jeffmakes/tr19-badge-hw-public/assembly/tr19-badge-B.Assembly.pdf

C7 C8 | C9

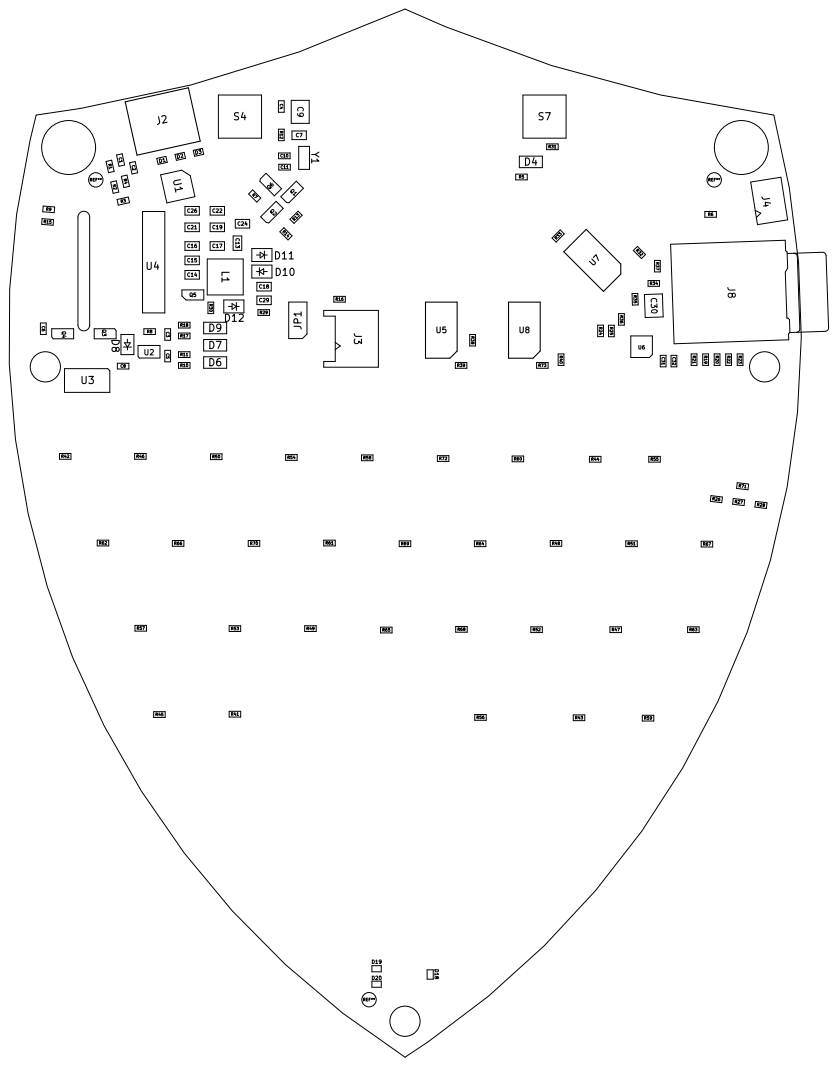
[picture p1: page 1]
