jeffmakes/tr19-badge-hw-public/assembly/tr19-badge-F.Assembly.pdf

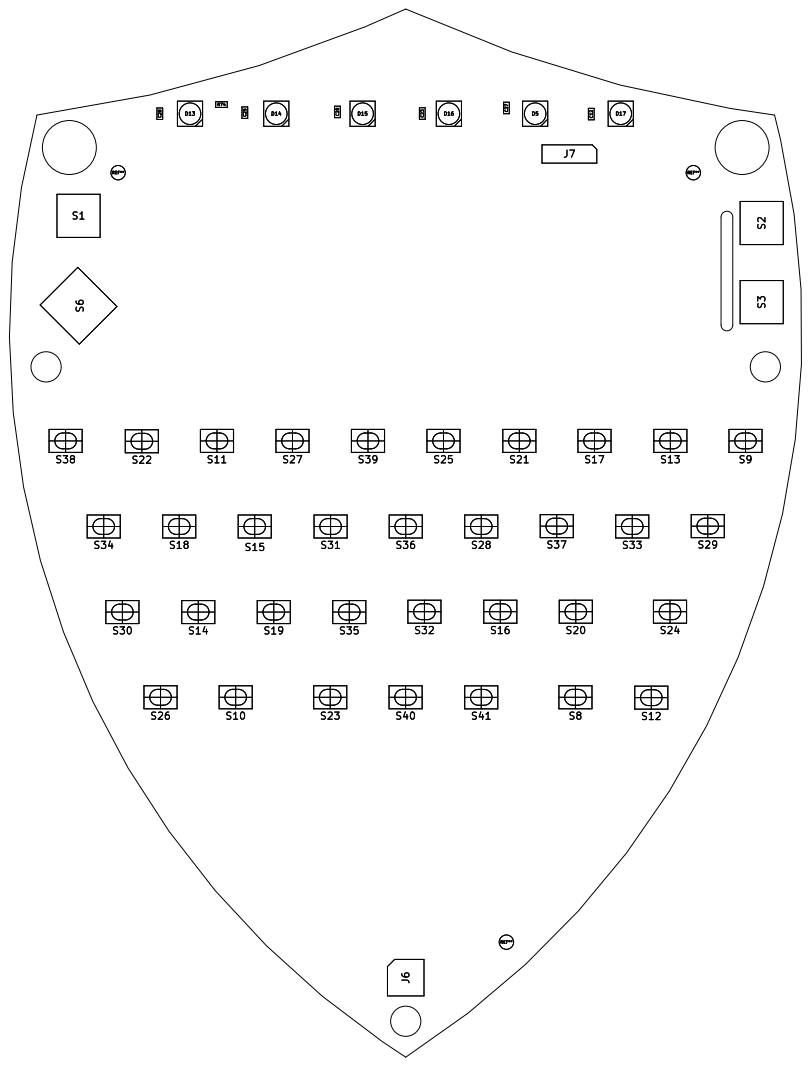
[picture p2: page 1]
