jeffmakes/tr19-badge-hw-public/gerber/panelisation-6-up.pdf

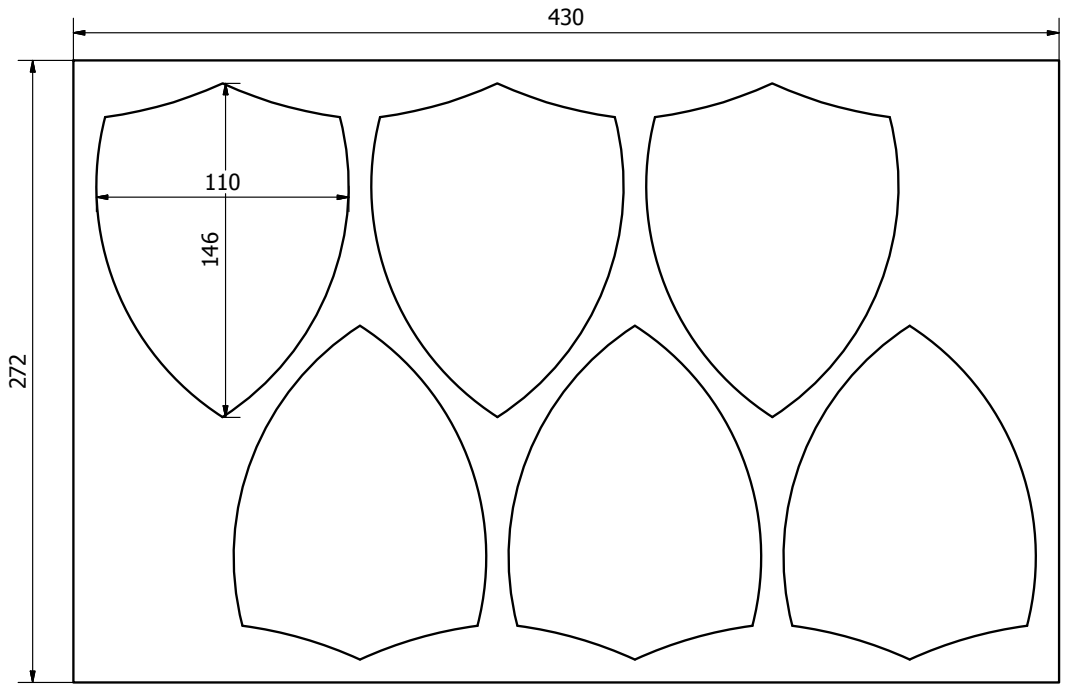
[picture p3: page 1]
Panelisation 2; Alan Ambrose; Designed by; Checked by; Approved by; Date
