jeffmakes/tr19-badge-hw-public/tr19-badge.kicad/tr19-badge.kicad_pcb

## KiCad design tr19-badge.kicad/tr19-badge.kicad_pcb (2019-07-17)

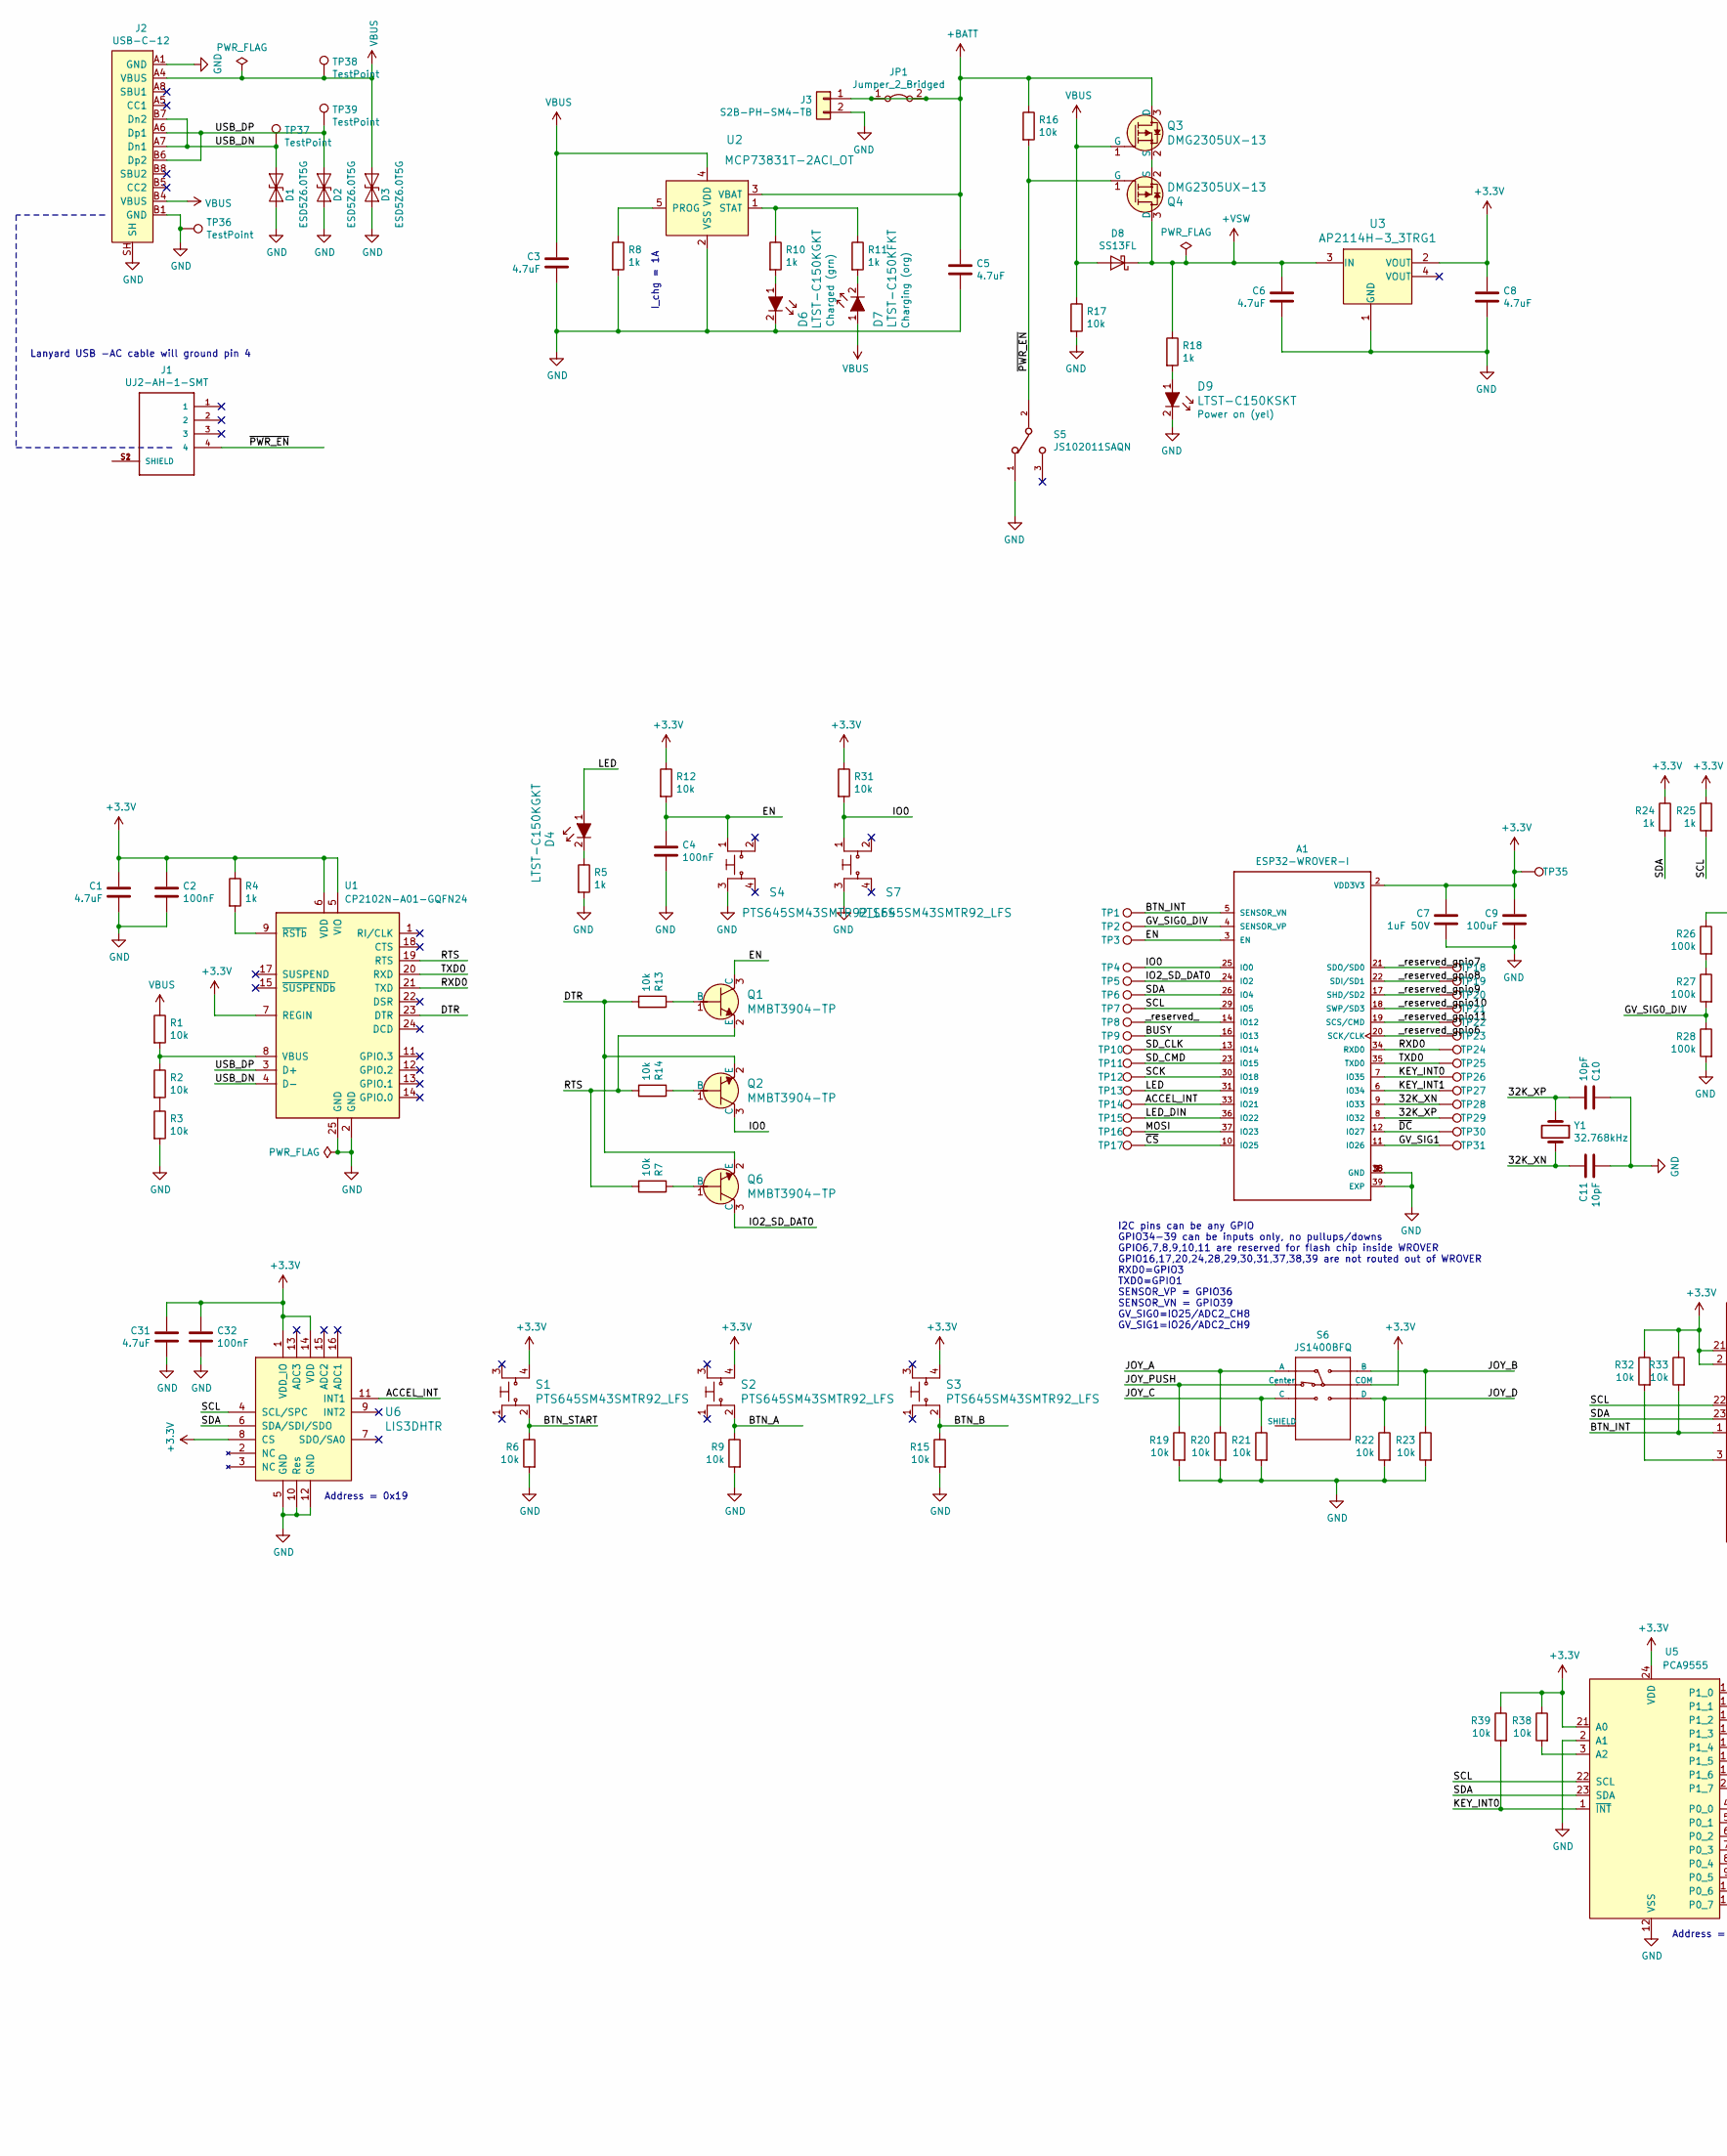
[picture p4: schematic tr19-badge.sch, part in row 1, column 1]

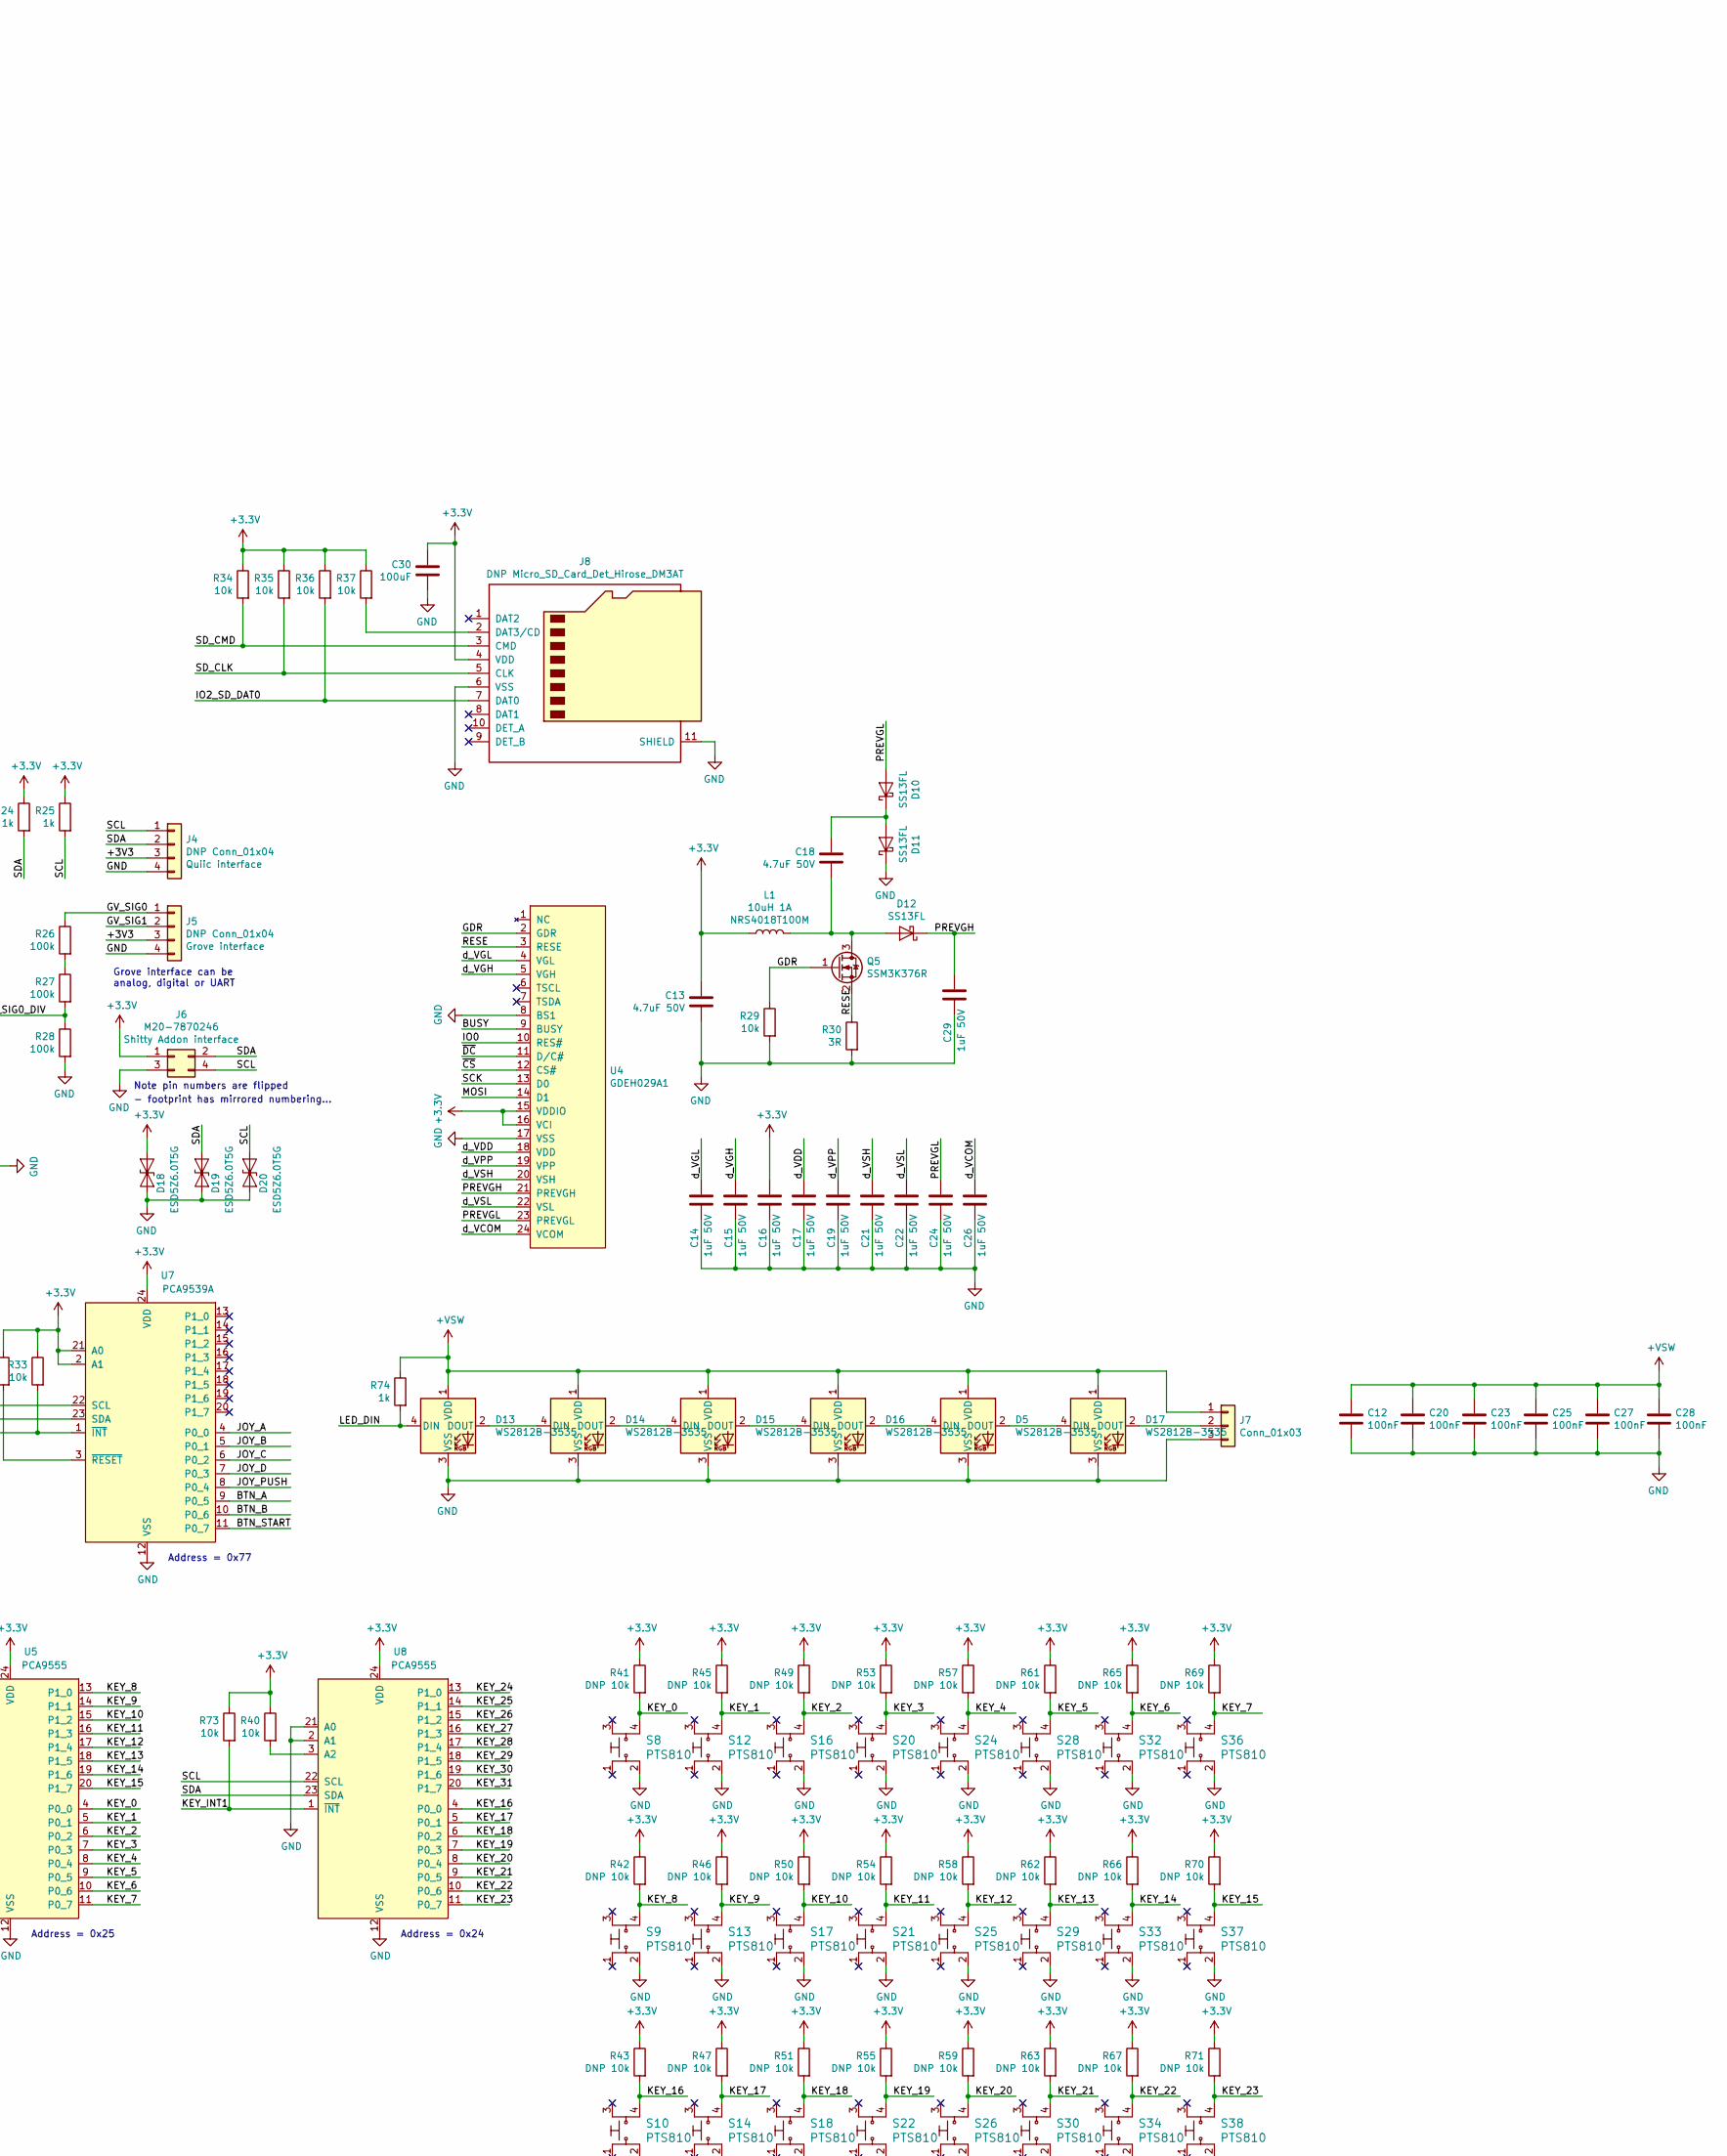
[picture p5: schematic tr19-badge.sch, part in row 1, column 2]

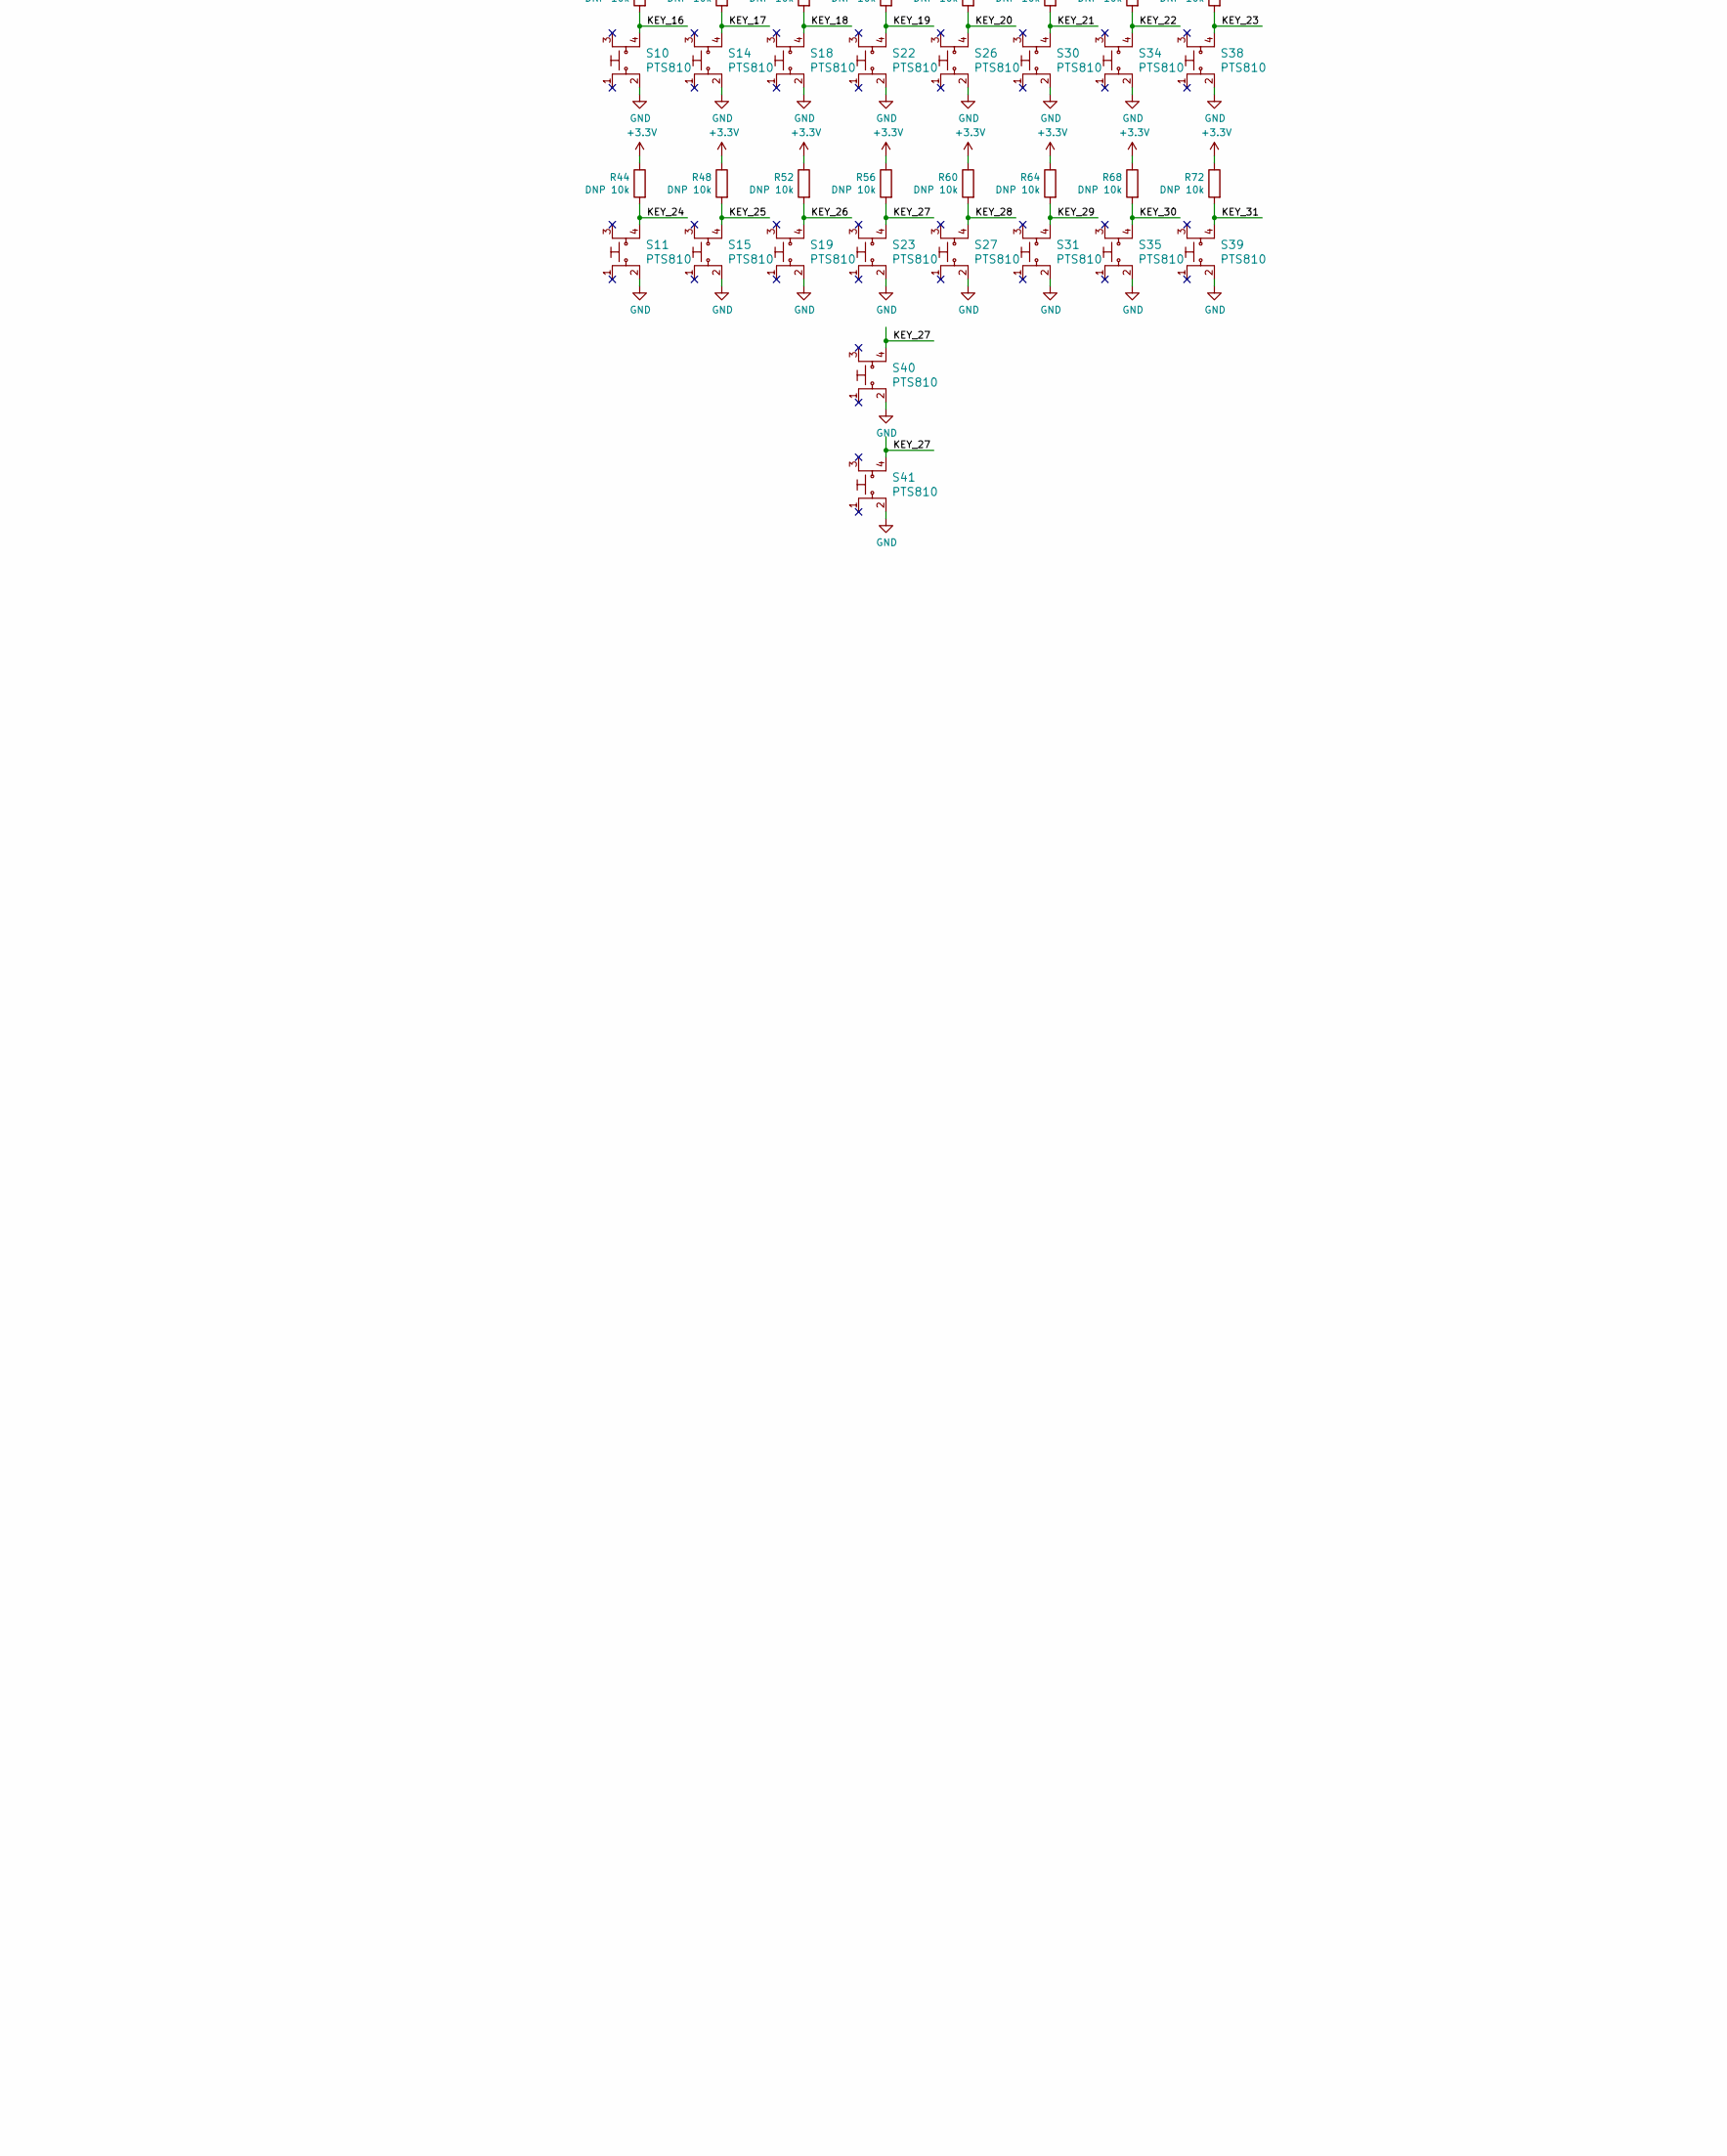
[picture p6: schematic tr19-badge.sch, part in row 2, column 2]

Parts:
A1: ESP32-WROVER-I
C1, C3, C5, C6, C8, C31: 4.7uF; C_0603_1608Metric
C2, C4, C12, C20, C23, C25, C27, C28, C32: 100nF; C_0603_1608Metric
C7, C14, C15, C16, C17, C19, C21, C22, C24, C26, C29: 1uF 50V; C_0805_2012Metric
C9, C30: 100uF; C_1210_3225Metric
C10, C11: 10pF; C_0603_1608Metric
C13, C18: 4.7uF 50V; C_0805_2012Metric
D1, D2, D3, D18, D19, D20: ESD5Z6.0T5G; SOD-523-numbered-pads; MPN ESD5Z5.0VC
D4, D6: LTST-C150KGKT; 1206; MPN LTST-C150KGKT; Digi-Key_PN 160-1404-1-ND
D5, D13, D14, D15, D16, D17: WS2812B-3535; LED_SK6812MINI_PLCC4_3.5x3.5mm_P1.75mm_no_silk
D7: LTST-C150KFKT; 1206; MPN LTST-C150KSKT; Digi-Key_PN 160-1406-1-ND
D8, D10, D11, D12: SS13FL; D_SOD-123F
D9: LTST-C150KSKT; 1206; MPN LTST-C150KSKT; Digi-Key_PN 160-1406-1-ND
J1: UJ2-AH-1-SMT; jing-lcsc-C46400
J2: USB-C-12; jing-usb-c-lcsc-C167321
J3: S2B-PH-SM4-TB; JST_PH_S2B-PH-SM4-TB_1x02-1MP_P2.00mm_Horizontal
J4: DNP Conn_01x04; JST_SH_SM04B-SRSS-TB_1x04-1MP_P1.00mm_Horizontal
J5: DNP Conn_01x04; 1125R-SMT-4P
J6: M20-7870246; PinSocket_2x02_P2.54mm_Vertical_mirror_numbering
J7: Conn_01x03; PinHeader_1x03_P2.54mm_Vertical
J8: DNP Micro_SD_Card_Det_Hirose_DM3AT; microSD_HC_Hirose_DM3AT-SF-PEJM5
JP1: Jumper_2_Bridged; PinHeader_1x02_P2.54mm_Vertical
L1: 10uH 1A; L_Taiyo-Yuden_MD-5050; MPN NRS4018T100M
Q1, Q2, Q6: MMBT3904-TP; SOT-23-3; MPN MMBT3904-TP; Digi-Key_PN MMBT3904TPMSCT-ND
Q3, Q4: DMG2305UX-13; SOT-23-3; MPN DMG2305UX-13; Digi-Key_PN DMG2305UX-13DICT-ND
Q5: SSM3K376R; SOT-23
R1, R2, R3, R6, R7, R9, R12, R13, R14, R15, R16, R17, R19, R20, R21, R22, R23, R29, R31, R32, R33, R34, R35, R36, R37, R38, R39, R40, R73: 10k; R_0603_1608Metric
R4, R5, R8, R10, R11, R18, R24, R25, R74: 1k; R_0603_1608Metric
R26, R27, R28: 100k; R_0603_1608Metric
R30: 3R; R_0603_1608Metric
R41, R42, R43, R44, R45, R46, R47, R48, R49, R50, R51, R52, R53, R54, R55, R56, R57, R58, R59, R60, R61, R62, R63, R64, R65, R66, R67, R68, R69, R70, R71, R72: DNP 10k; R_0603_1608Metric
S1, S2, S3, S4, S7: PTS645SM43SMTR92_LFS; Switch_Tactile_SMD_6x6mm_PTS645; MPN PTS645SM43SMTR92 LFS; Digi-Key_PN CKN9112CT-ND
S5: JS102011SAQN; SW_JS102011SAQN
S6: JS1400BFQ; SW_JS1400BFQ-arrows
S8, S9, S10, S11, S12, S13, S14, S15, S16, S17, S18, S19, S20, S21, S22, S23, S24, S25, S26, S27, S28, S29, S30, S31, S32, S33, S34, S35, S36, S37, S38, S39, S40, S41: PTS810; PTS-810; MPN PTS645SM43SMTR92 LFS; Digi-Key_PN CKN9112CT-ND
TP1, TP2, TP3, TP4, TP5, TP6, TP7, TP8, TP9, TP10, TP11, TP12, TP13, TP14, TP15, TP16, TP17, TP18, TP19, TP20, TP21, TP22, TP23, TP24, TP25, TP26, TP27, TP28, TP29, TP30, TP31, TP35: test-pad-1.4-TH
TP36, TP37, TP38, TP39: TestPoint; test-pad-1.4-TH
U1: CP2102N-A01-GQFN24; QFN-24-1EP_4x4mm_P0.5mm_EP2.6x2.6mm
U2: MCP73831T-2ACI_OT; SOT-753; MPN MCP73831T-2ACI/OT; Digi-Key_PN MCP73831T-2ACI/OTCT-ND
U3: AP2114H-3_3TRG1; SOT-223; MPN AP2114H-3.3TRG1; Digi-Key_PN AP2114H-3.3TRG1DICT-ND
U4: GDEH029A1
U5, U8: PCA9555; TSSOP-24_4.4x7.8mm_P0.65mm
U6: LIS3DHTR; VFLGA-16_3x3mm; MPN LIS3DHTR; Digi-Key_PN 497-10613-1-ND
U7: PCA9539A; TSSOP-24_4.4x7.8mm_P0.65mm
Y1: 32.768kHz; Crystal_SMD_3215-2Pin_3.2x1.5mm; MPN SSP-T7-F

Connections:
+BATT: C5.1, J3.1, JP1.1 (A), JP1.2 (B), Q3.3 (D), R16.1, U2.3 (VBAT)
+VSW: C6.1, C12.1, C20.1, C23.1, C25.1, C27.1, C28.1, D5.1 (VDD), D8.1 (K), D13.1 (VDD), D14.1 (VDD), D15.1 (VDD), D16.1 (VDD), D17.1 (VDD), J7.1, Q4.3 (D), R18.1, R74.1, U3.3 (IN)
/32K_XN: A1.9 (IO33), C11.1, TP28.1, Y1.2
/32K_XP: A1.8 (IO32), C10.2, TP29.1, Y1.1
/ACCEL_INT: A1.33 (IO21), TP14.1, U6.11 (INT1)
/BTN_A: R9.1, S2.2, U7.9 (P0_5)
/BTN_B: R15.1, S3.2, U7.10 (P0_6)
/BTN_INT: A1.5 (SENSOR_VN), R33.2, TP1.1, U7.1 (~INT~)
/BTN_START: R6.1, S1.2, U7.11 (P0_7)
/BUSY: A1.16 (IO13), TP9.1, U4.9 (BUSY)
/DTR: Q2.2 (E), Q6.2 (E), R13.2, U1.23 (DTR)
/EN: A1.3 (EN), C4.1, Q1.3 (C), R12.2, S4.1, TP3.1
/GDR: Q5.1 (G), R29.1, U4.2 (GDR)
/GV_SIG0: J5.1, R26.1
/GV_SIG0_DIV: A1.4 (SENSOR_VP), R27.2, R28.1, TP2.1
/GV_SIG1: A1.11 (IO26), J5.2, TP31.1
/IO0: A1.25 (IO0), Q2.3 (C), R31.2, S7.1, TP4.1, U4.10 (RES#)
/IO2_SD_DAT0: A1.24 (IO2), J8.7 (DAT0), Q6.3 (C), R36.2, TP5.1
/JOY_A: R20.1, S6.1 (A), U7.4 (P0_0)
/JOY_B: R23.1, S6.4 (B), U7.5 (P0_1)
/JOY_C: R21.1, S6.3 (C), U7.6 (P0_2)
/JOY_D: R22.1, S6.6 (D), U7.7 (P0_3)
/JOY_PUSH: R19.1, S6.2 (Center), U7.8 (P0_4)
/KEY_0: R41.2, S8.4, U5.4 (P0_0)
/KEY_1: R45.2, S12.4, U5.5 (P0_1)
/KEY_2: R49.2, S16.4, U5.6 (P0_2)
/KEY_3: R53.2, S20.4, U5.7 (P0_3)
/KEY_4: R57.2, S24.4, U5.8 (P0_4)
/KEY_5: R61.2, S28.4, U5.9 (P0_5)
/KEY_6: R65.2, S32.4, U5.10 (P0_6)
/KEY_7: R69.2, S36.4, U5.11 (P0_7)
/KEY_8: R42.2, S9.4, U5.13 (P1_0)
/KEY_9: R46.2, S13.4, U5.14 (P1_1)
/KEY_10: R50.2, S17.4, U5.15 (P1_2)
/KEY_11: R54.2, S21.4, U5.16 (P1_3)
/KEY_12: R58.2, S25.4, U5.17 (P1_4)
/KEY_13: R62.2, S29.4, U5.18 (P1_5)
/KEY_14: R66.2, S33.4, U5.19 (P1_6)
/KEY_15: R70.2, S37.4, U5.20 (P1_7)
/KEY_16: R43.2, S10.4, U8.4 (P0_0)
/KEY_17: R47.2, S14.4, U8.5 (P0_1)
/KEY_18: R51.2, S18.4, U8.6 (P0_2)
/KEY_19: R55.2, S22.4, U8.7 (P0_3)
/KEY_20: R59.2, S26.4, U8.8 (P0_4)
/KEY_21: R63.2, S30.4, U8.9 (P0_5)
/KEY_22: R67.2, S34.4, U8.10 (P0_6)
/KEY_23: R71.2, S38.4, U8.11 (P0_7)
/KEY_24: R44.2, S11.4, U8.13 (P1_0)
/KEY_25: R48.2, S15.4, U8.14 (P1_1)
/KEY_26: R52.2, S19.4, U8.15 (P1_2)
/KEY_27: R56.2, S23.4, S40.4, S41.4, U8.16 (P1_3)
/KEY_28: R60.2, S27.4, U8.17 (P1_4)
/KEY_29: R64.2, S31.4, U8.18 (P1_5)
/KEY_30: R68.2, S35.4, U8.19 (P1_6)
/KEY_31: R72.2, S39.4, U8.20 (P1_7)
/KEY_INT0: A1.7 (IO35), R39.2, TP26.1, U5.1 (~INT~)
/KEY_INT1: A1.6 (IO34), R73.2, TP27.1, U8.1 (~INT~)
/LED: A1.31 (IO19), D4.1, TP13.1
/LED_DIN: A1.36 (IO22), D13.4 (DIN), R74.2, TP15.1
/MOSI: A1.37 (IO23), TP16.1, U4.14 (D1)
/PREVGH: C29.2, D12.1 (K), U4.21 (PREVGH)
/PREVGL: C24.2, D10.2 (A), U4.23 (PREVGL)
/RESE: Q5.2 (S), R30.1, U4.3 (RESE)
/RTS: Q1.2 (E), R7.2, R14.2, U1.19 (RTS)
/RXD0: A1.34 (RXD0), TP24.1, U1.21 (TXD)
/SCK: A1.30 (IO18), TP12.1, U4.13 (D0)
/SCL: A1.29 (IO5), D20.1 (A1), J4.1, J6.4, R25.2, TP7.1, U5.22 (SCL), U6.4 (SCL/SPC), U7.22 (SCL), U8.22 (SCL)
/SDA: A1.26 (IO4), D19.1 (A1), J4.2, J6.2, R24.2, TP6.1, U5.23 (SDA), U6.6 (SDA/SDI/SDO), U7.23 (SDA), U8.23 (SDA)
/SD_CLK: A1.13 (IO14), J8.5 (CLK), R35.2, TP10.1
/SD_CMD: A1.23 (IO15), J8.3 (CMD), R34.2, TP11.1
/TXD0: A1.35 (TXD0), TP25.1, U1.20 (RXD)
/USB_DN: D1.1 (A1), J2.A7 (Dn1), J2.B7 (Dn2), TP37.1, U1.4 (D-)
/USB_DP: D2.1 (A1), J2.A6 (Dp1), J2.B6 (Dp2), TP39.1, U1.3 (D+)
/_reserved_: A1.14 (IO12), TP8.1
/_reserved_gpio6: A1.20 (SCK/CLK), TP23.1
/_reserved_gpio7: A1.21 (SDO/SD0), TP18.1
/_reserved_gpio8: A1.22 (SDI/SD1), TP19.1
/_reserved_gpio9: A1.17 (SHD/SD2), TP20.1
/_reserved_gpio10: A1.18 (SWP/SD3), TP21.1
/_reserved_gpio11: A1.19 (SCS/CMD), TP22.1
/d_VCOM: C26.2, U4.24 (VCOM)
/d_VDD: C17.2, U4.18 (VDD)
/d_VGH: C15.2, U4.5 (VGH)
/d_VGL: C14.2, U4.4 (VGL)
/d_VPP: C19.2, U4.19 (VPP)
/d_VSH: C21.2, U4.20 (VSH)
/d_VSL: C22.2, U4.22 (VSL)
/~CS~: A1.10 (IO25), TP17.1, U4.12 (CS#)
/~DC~: A1.12 (IO27), TP30.1, U4.11 (D/C#)
/~PWR_EN~: J1.4, Q4.1 (G), R16.2, S5.2
GND: A1.1 (GND), A1.15 (GND), A1.38 (GND), A1.39 (EXP), C1.2, C2.2, C3.2, C4.2, C5.2, C6.2, C7.2, C8.2, C9.2, C10.1, C11.2, C12.2, C13.2, C14.1, C15.1, C16.1, C17.1, C19.1, C20.2, C21.1, C22.1, C23.2, C24.1, C25.2, C26.1, C27.2, C28.2, C29.1, C30.2, C31.2, C32.2, D1.2 (A2), D2.2 (A2), D3.2 (A2), D5.3 (VSS), D6.2, D9.2, D11.1 (K), D13.3 (VSS), D14.3 (VSS), D15.3 (VSS), D16.3 (VSS), D17.3 (VSS), D18.2 (A2), D19.2 (A2), D20.2 (A2), J2.A1 (GND), J2.B1 (GND), J2.SH, J3.2, J4.4, J5.4, J6.3, J7.3, J8.6 (VSS), J8.11 (SHIELD), R3.2, R5.2, R6.2, R8.2, R9.2, R15.2, R17.2, R19.2, R20.2, R21.2, R22.2, R23.2, R28.2, R29.2, R30.2, S4.3, S5.1, S7.3, S8.2, S9.2, S10.2, S11.2, S12.2, S13.2, S14.2, S15.2, S16.2, S17.2, S18.2, S19.2, S20.2, S21.2, S22.2, S23.2, S24.2, S25.2, S26.2, S27.2, S28.2, S29.2, S30.2, S31.2, S32.2, S33.2, S34.2, S35.2, S36.2, S37.2, S38.2, S39.2, S40.2, S41.2, TP36.1, U1.2 (GND), U1.25 (GND), U2.2 (VSS), U3.1 (GND), U4.8 (BS1), U4.17 (VSS), U5.2 (A1), U5.12 (VSS), U6.5 (GND), U6.10 (Res), U6.12 (GND), U7.12 (VSS), U8.2 (A1), U8.12 (VSS), U8.21 (A0)
unnamed: C18.1, D10.1 (K), D11.2 (A)
unnamed: C18.2, D12.2 (A), L1.2, Q5.3 (D)
unnamed: D4.2, R5.1
unnamed: D6.1, R10.2
unnamed: D7.2, R11.2
unnamed: D9.1, R18.2
unnamed: D13.2 (DOUT), D14.4 (DIN)
unnamed: D14.2 (DOUT), D15.4 (DIN)
unnamed: D15.2 (DOUT), D16.4 (DIN)
unnamed: D5.4 (DIN), D16.2 (DOUT)
unnamed: D17.2 (DOUT), J7.2
unnamed: D5.2 (DOUT), D17.4 (DIN)
unnamed: J1.S1 (SHIELD), J1.S2 (SHIELD)
unnamed: J8.2 (DAT3/CD), R37.2
unnamed: Q1.1 (B), R13.1
unnamed: Q2.1 (B), R14.1
unnamed: Q3.2 (S), Q4.2 (S)
unnamed: Q6.1 (B), R7.1
unnamed: R1.2, R2.1, U1.8 (VBUS)
unnamed: R2.2, R3.1
unnamed: R4.2, U1.9 (~RSTb)
unnamed: R8.1, U2.5 (PROG)
unnamed: R10.1, R11.1, U2.1 (STAT)
unnamed: R26.2, R27.1
unnamed: R32.2, U7.3 (~RESET~)
unnamed: R38.2, U5.3 (A2)
unnamed: R40.2, U8.3 (A2)
unnamed: S6.SH1 (SHIELD), S6.SH2 (SHIELD)
VBUS: C3.1, D3.1 (A1), D7.1, D8.2 (A), J2.A4 (VBUS), J2.B4 (VBUS), Q3.1 (G), R1.1, R17.1, TP38.1, U2.4 (VDD)

Notes on the sheet:
I_chg = 1A
Lanyard USB -AC cable will ground pin 4
Grove interface can be analog, digital or UART
I2C pins can be any GPIO GPIO34-39 can be inputs only, no pullups/downs GPIO6,7,8,9,10,11 are reserved for flash chip inside WROVER GPIO16,17,20,24,28,29,30,31,37,38,39 are not routed out of WROVER RXD0=GPIO3 TXD0=GPIO1 SENSOR_VP = GPIO36 SENSOR_VN = GPIO39 GV_SIG0=IO25/ADC2_CH8 GV_SIG1=IO26/ADC2_C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
Note pin numbers are flipped
- footprint has mirrored numbering...
Address = 0x77
Address = 0x19
Address = 0x25
Address = 0x24

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
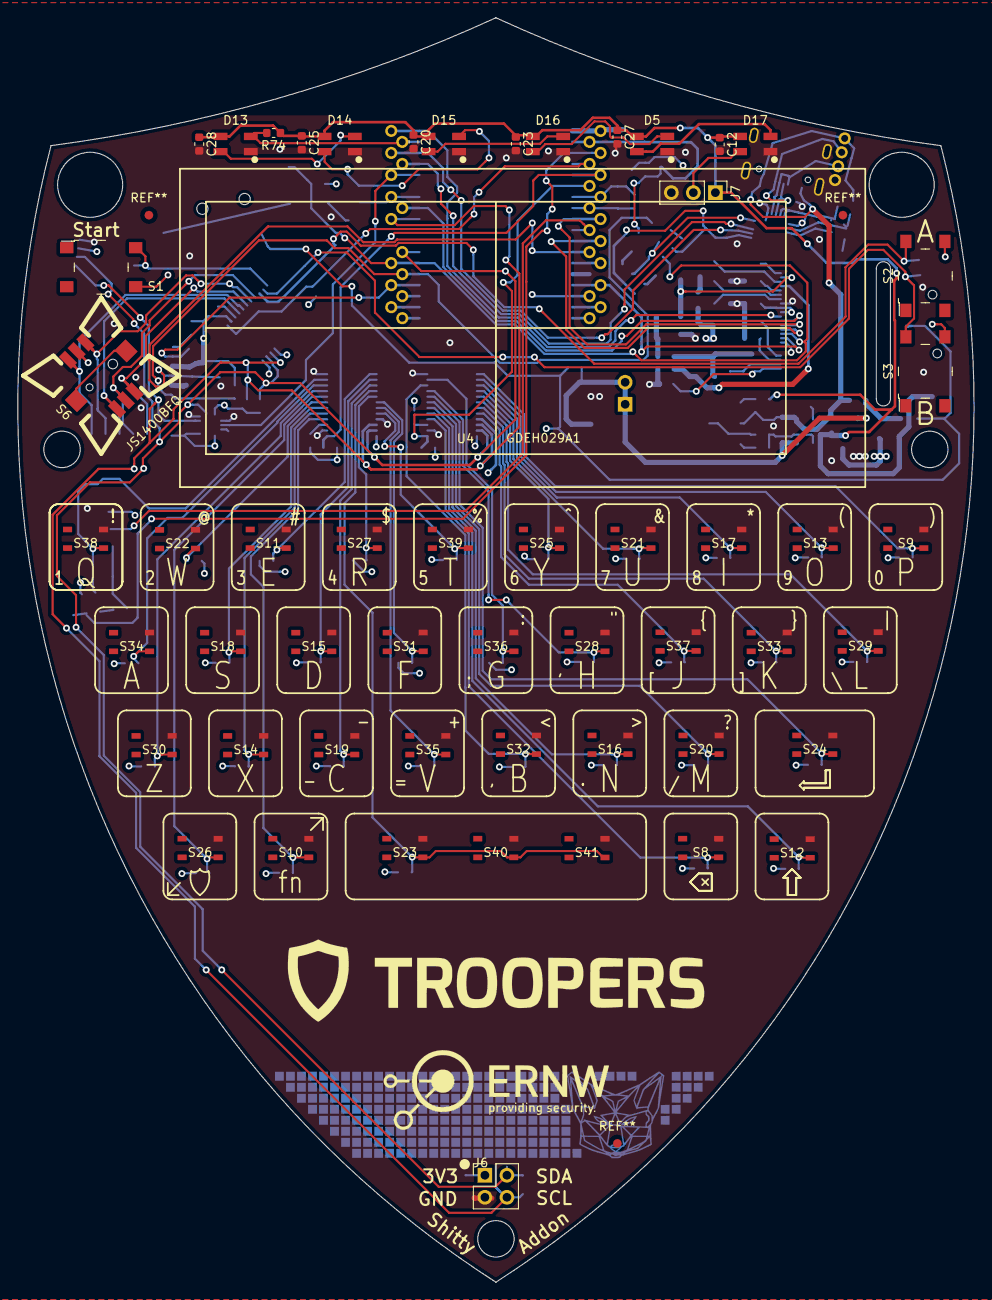
[picture p7: board tr19-badge.kicad_pcb from above]

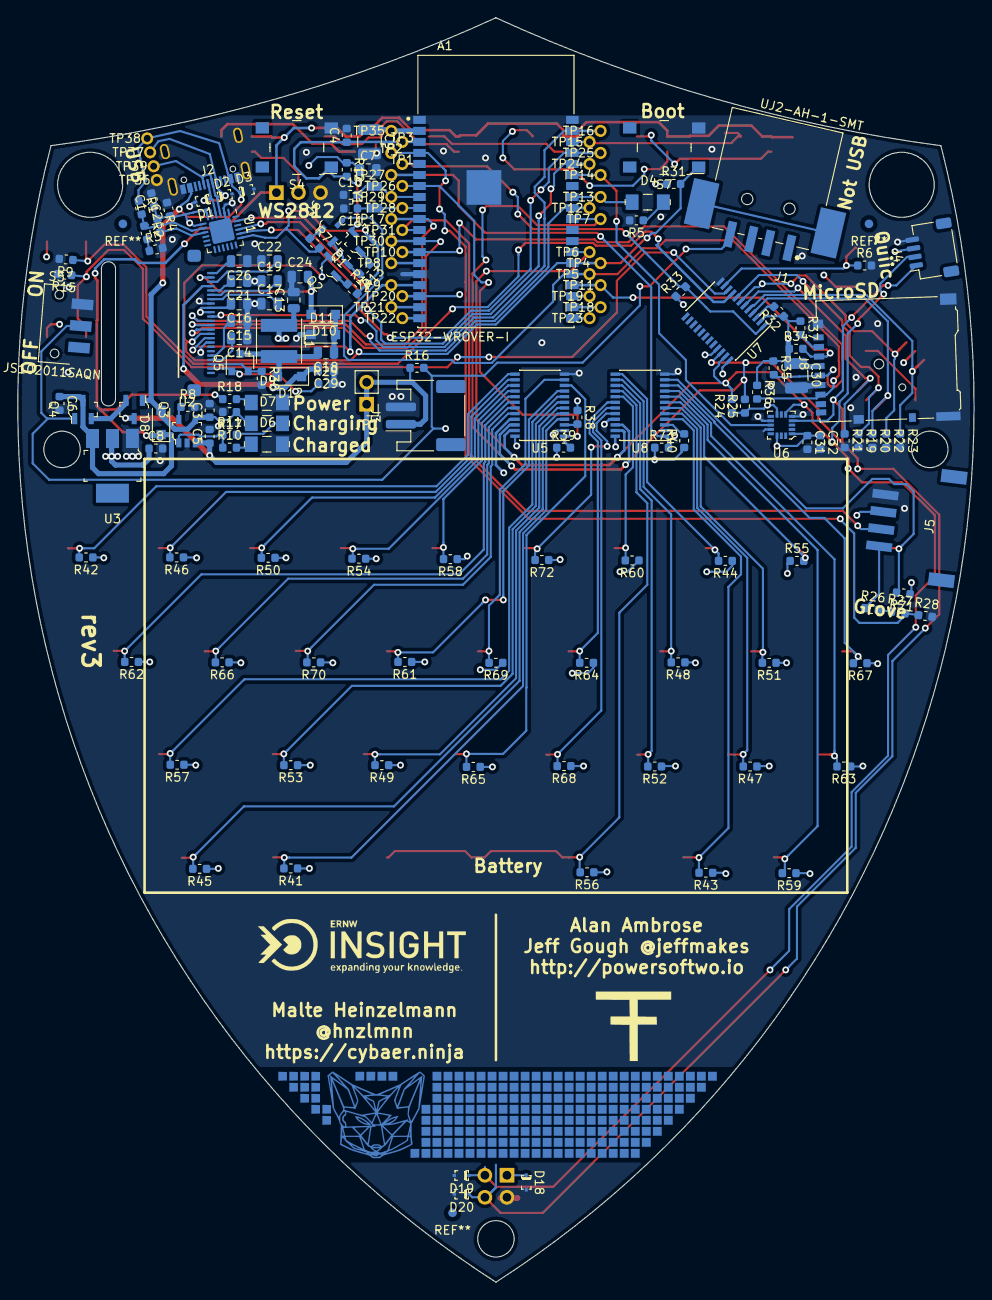
[picture p8: board tr19-badge.kicad_pcb from below]

Board: 4 copper layers, 110.2 x 145.8 mm, 234 parts (177 on the bottom side), 121 nets.

Other parts of the board:
Ref**: Val**; poft-icon-8mm
Ref**#2: Val**; fuccs-soldering
Ref**#3: Val**; trroopers-48mm
Ref**#4: Val**; ernw-26mm
Ref**#5: Val**; ernw-insight-24mm
