jeffmakes/tr19-badge-hw-public/tr19-badge.kicad/annotated-print.kicad_pcb

## KiCad design tr19-badge.kicad/annotated-print.kicad_pcb (2019-07-17)

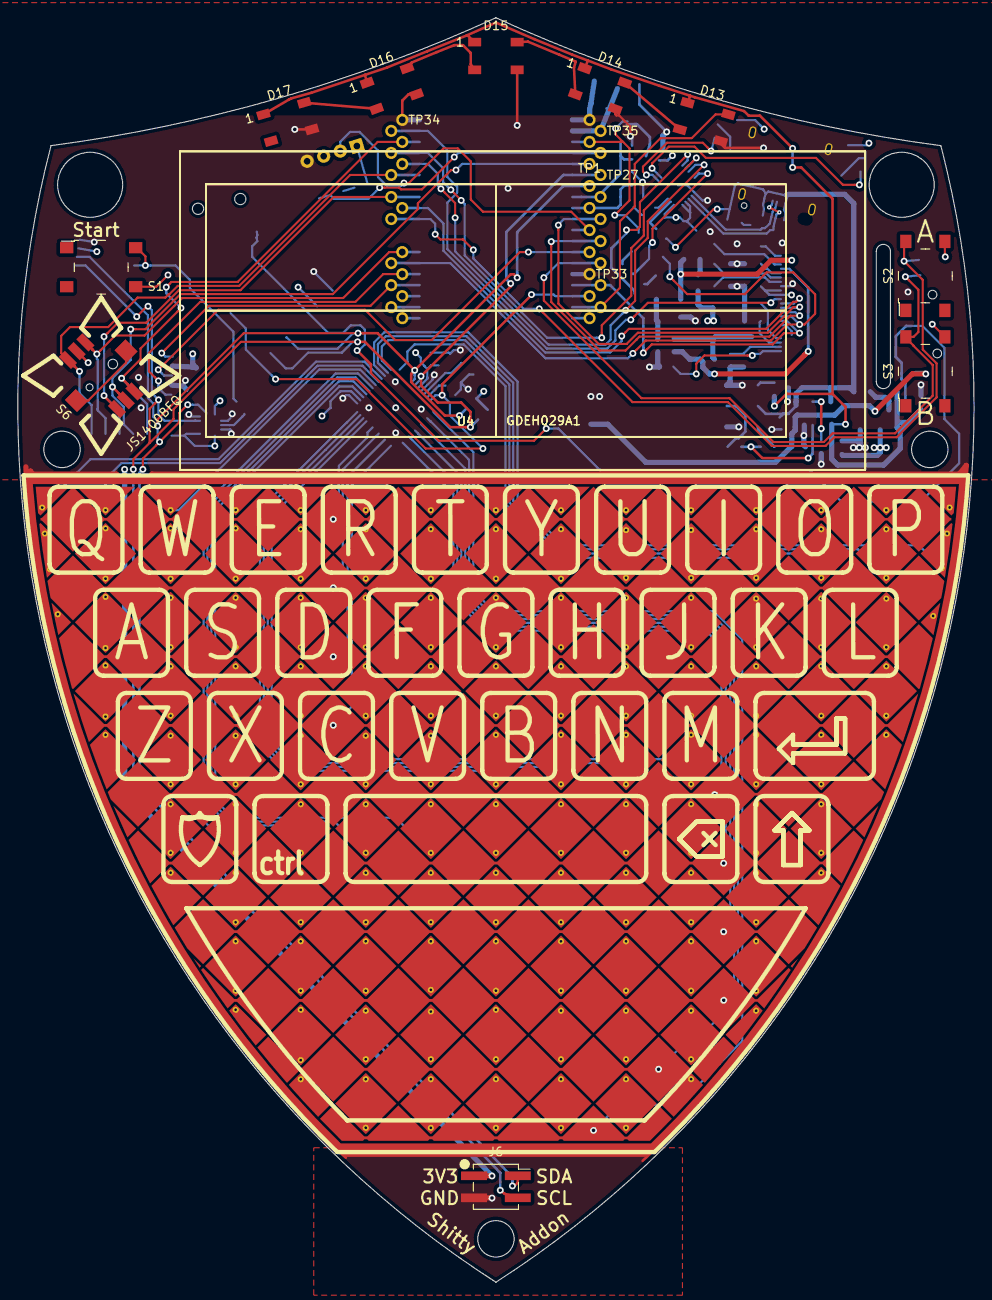
[picture p9: board annotated-print.kicad_pcb from above]

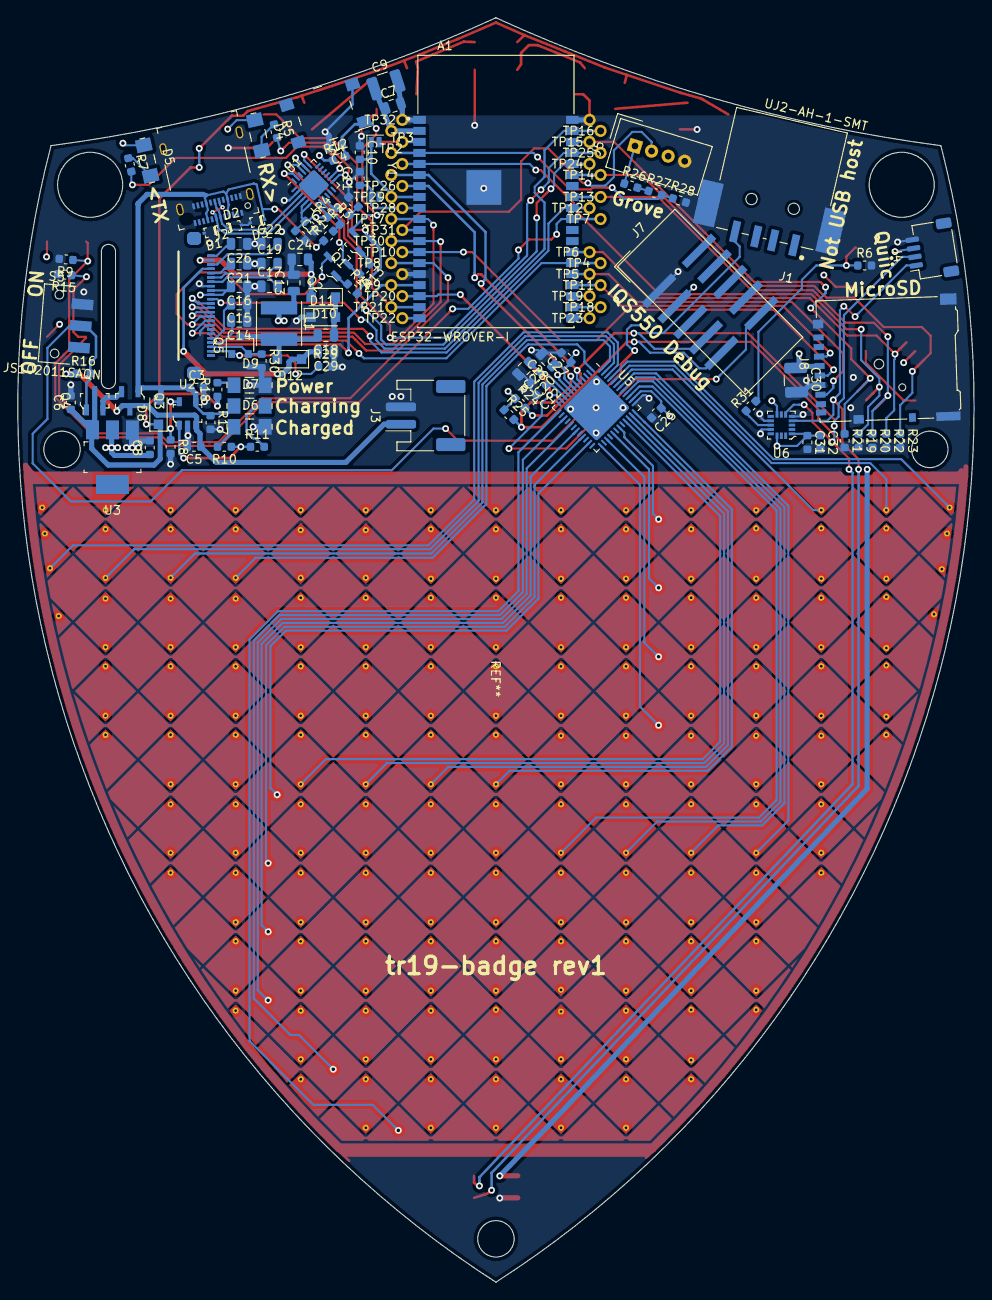
[picture p10: board annotated-print.kicad_pcb from below]

Board: 4 copper layers, 110.2 x 145.8 mm, 145 parts (127 on the bottom side), 108 nets.

Parts:
A1: ESP32-WROVER-I; XCVR_ESP32-WROVER-I
A2: tr19_touch_array; electrode-array-2
C1, C3, C5, C6, C8, C31: 4.7uF; C_0603_1608Metric
C2, C4, C12, C25, C32: 100nF; C_0603_1608Metric
C7, C23, C28: 1uF; C_0805_2012Metric
C9, C30: 100uF; C_1210_3225Metric
C10, C11: 10pF; C_0603_1608Metric
C13, C18: 4.7uF 50V; C_0805_2012Metric
C14, C15, C16, C17, C19, C21, C22, C24, C26, C29: 1uF 50V; C_0805_2012Metric
C20, C27: 100pF; C_0603_1608Metric
D1, D2, D3: ESD5Z6.0T5G; SOD-523-numbered-pads
D4, D6: LTST-C150KGKT; 1206
D5, D7: LTST-C150KFKT; 1206
D8, D10, D11, D12: DSS13UTR; D_SOD-123F
D9: LTST-C150KSKT; 1206
D13, D14, D15, D16, D17: WS2812B; LED_WS2812B_PLCC4_5.0x5.0mm_P3.2mm_no-silk
J1: UJ2-AH-1-SMT; CUI_UJ2-AH-1-SMT
J2: 12401610E4_2A; USB_Type_C_Female__12401610E4_2A
J3: S2B-PH-SM4-TB; JST_PH_S2B-PH-SM4-TB_1x02-1MP_P2.00mm_Horizontal
J4: Conn_01x04; JST_SH_SM04B-SRSS-TB_1x04-1MP_P1.00mm_Horizontal
J5: Conn_01x04; NS-Tech_Grove_1x04_P2mm_Vertical
J6: M20-7870246; PinSocket_2x02_P2.54mm_Vertical_SMD
J7: 3020-10-0300-00; IDC-Header_2x05_P2.54mm_Vertical_SMD
J8: Micro_SD_Card_Det_Hirose_DM3AT; microSD_HC_Hirose_DM3AT-SF-PEJM5
L1: 10uH 1A; L_Taiyo-Yuden_MD-5050
Q1, Q2: MMBT3904-TP; SOT-23-3
Q3, Q4: DMG2305UX-13; SOT-23-3
Q5: SSM3K376R; SOT-23
R1, R2, R3, R6, R9, R12, R13, R14, R15, R16, R17, R19, R20, R21, R22, R23, R24, R25, R29: 10k; R_0603_1608Metric
R4, R5, R7, R8, R10, R11, R18, R31: 1k; R_0603_1608Metric
R26, R27, R28: 100k; R_0603_1608Metric
R30: 3R; R_0603_1608Metric
S1, S2, S3, S4: PTS645SM43SMTR92_LFS; Switch_Tactile_SMD_6x6mm_PTS645
S5: JS102011SAQN; SW_JS102011SAQN
S6: JS1400BFQ; SW_JS1400BFQ-arrows
TP1, TP2, TP3, TP4, TP5, TP6, TP7, TP8, TP9, TP10, TP11, TP12, TP13, TP14, TP15, TP16, TP17, TP18, TP19, TP20, TP21, TP22, TP23, TP24, TP25, TP26, TP27, TP28, TP29, TP30, TP31, TP32, TP33, TP34, TP35: test-pad-1.4-TH
U1: CP2102N-A01-GQFN24; QFN-24-1EP_4x4mm_P0.5mm_EP2.6x2.6mm
U2: MCP73831T-2ACI_OT; SOT-753
U3: AP2114H-3_3TRG1; SOT-223
U4, U4#2: GDEH029A1
U5: IQS550; QFN-48-1EP_7x7mm_P0.5mm_EP5.45x5.45mm
U6: LIS3DHTR; VFLGA-16_3x3mm
Y1: 32.768kHz; Crystal_SMD_SeikoEpson_MC146-4Pin_6.7x1.5mm

Connections:
+3V3: A1.2, C1.1, C2.1, C7.1, C8.1, C9.1, C13.1, C16.2, C25.1, C27.1, C28.1, C30.1, C31.1, C32.1, D4.1, D5.1, J4.3, J5.3, J6.2, J7.3, J8.4, L1.1, R4.1, R12.1, R24.1, R25.1, S1.4, S2.4, S3.4, S6.5, TP35.1, U1.5, U1.6, U1.7, U3.2, U4.15, U4.16, U4#2.15, U4#2.16, U5.7, U5.38, U6.1, U6.8, U6.14
+BATT: C5.1, J3.1, Q3.3, R16.1, U2.3
+VSW: C6.1, D8.1, D13.1, D14.1, D15.1, D16.1, D17.1, Q4.3, R18.1, U3.3
/32K_XN: A1.9, C11.1, TP28.1, Y1.2
/32K_XP: A1.8, C10.2, TP29.1, Y1.1
/ACCEL_INT: R31.1, U6.11
/BTN_A: A1.29, R9.1, S2.2, TP7.1
/BTN_B: A1.14, R15.1, S3.2, TP8.1
/BTN_START: R6.1, R31.2, S1.2
/BUSY: A1.16, TP9.1, U4.9, U4#2.9
/DTR: Q2.2, R13.2, U1.23
/EN: A1.3, C4.1, Q1.3, R12.2, S4.1, TP3.1
/GDR: Q5.1, R29.1, U4.2, U4#2.2
/GV_SIG0: J5.1, R26.1
/GV_SIG0_DIV: A1.4, R27.2, R28.1, TP2.1
/GV_SIG1: A1.11, J5.2, TP31.1
/IO0: A1.25, Q2.3, TP4.1, U4.10, U4#2.10
/IQ_RDY: A1.17, J7.10, TP20.1, U5.11
/JOY_A: A1.31, R20.1, S6.1, TP13.1
/JOY_B: A1.33, R23.1, S6.4, TP14.1
/JOY_C: A1.36, R21.1, S6.3, TP15.1
/JOY_D: A1.26, R22.1, S6.6, TP6.1
/JOY_PUSH: A1.5, R19.1, S6.2, TP1.1
/LED_DIN: A1.18, D13.4, TP21.1
/MOSI: A1.37, TP16.1, U4.14, U4#2.14
/PREVGH: C29.2, D12.1, U4.21, U4#2.21
/PREVGL: C24.2, D10.2, U4.23, U4#2.23
/RESE: Q5.2, R30.1, U4.3, U4#2.3
/RTS: Q1.2, R14.2, U1.19
/RXD0: A1.34, TP24.1, U1.21
/RXT: R5.2, U1.13
/Rx0A: A2.RX9, U5.13
/Rx1A: A2.RX8, U5.15
/Rx2A: A2.RX7, U5.17
/Rx3A: A2.RX6, U5.19
/Rx4A: A2.RX5, U5.21
/Rx5A: A2.RX4, U5.23
/Rx6A: A2.RX3, U5.25
/Rx7A: A2.RX2, U5.27
/Rx8A: A2.RX1, U5.29
/Rx9A: A2.RX0, U5.31
/SCK: A1.30, TP12.1, U4.13, U4#2.13
/SCL: A1.6, J4.1, J6.3, J7.9, R25.2, TP27.1, U5.6, U6.4
/SDA: A1.7, J4.2, J6.1, J7.7, R24.2, TP26.1, U5.5, U6.6
/SD_CLK: A1.13, J8.5, TP10.1
/SD_CMD: A1.23, J8.3, TP11.1
/SD_DAT0: A1.24, J8.7, TP5.1
/TXD0: A1.35, TP25.1, U1.20
/TXT: R7.2, U1.14
/Tx0: A2.TX10, U5.33
/Tx1: A2.TX9, U5.34
/Tx2: A2.TX8, U5.35
/Tx3: A2.TX7, U5.36
/Tx4: A2.TX6, U5.39
/Tx5: A2.TX5, U5.40
/Tx6: A2.TX4, U5.41
/Tx7: A2.TX3, U5.42
/Tx8: A2.TX2, U5.43
/Tx9: A2.TX1, U5.44
/Tx10: A2.TX0, U5.45
/Tx11: A2.TX14, U5.46
/Tx12: A2.TX13, U5.47
/Tx13: A2.TX12, U5.48
/Tx14: A2.TX11, U5.1
/USB_DN: D1.1, J2.A7, J2.B7, U1.4
/USB_DP: D2.1, J2.A6, J2.B6, U1.3
/_reserved_gpio6: A1.20, TP23.1
/_reserved_gpio7: A1.21, TP18.1
/_reserved_gpio8: A1.22, TP19.1
/_reserved_gpio11: A1.19, TP22.1
/d_VCOM: C26.2, U4.24, U4#2.24
/d_VDD: C17.2, U4.18, U4#2.18
/d_VGH: C15.2, U4.5, U4#2.5
/d_VGL: C14.2, U4.4, U4#2.4
/d_VPP: C19.2, U4.19, U4#2.19
/d_VSH: C21.2, U4.20, U4#2.20
/d_VSL: C22.2, U4.22, U4#2.22
/~CS~: A1.10, TP17.1, U4.12, U4#2.12
/~DC~: A1.12, TP30.1, U4.11, U4#2.11
/~PWR_EN~: J1.4, Q4.1, R16.2, S5.2
GND: A1.1, A1.15, A1.38, A1.39, A2.GND, C1.2, C2.2, C3.2, C4.2, C5.2, C6.2, C7.2, C8.2, C9.2, C10.1, C11.2, C12.2, C13.2, C14.1, C15.1, C16.1, C17.1, C19.1, C20.2, C21.1, C22.1, C23.2, C24.1, C25.2, C26.1, C27.2, C28.2, C29.1, C30.2, C31.2, C32.2, D1.2, D2.2, D3.2, D6.2, D9.2, D11.1, D13.3, D14.3, D15.3, D16.3, D17.3, J1.S1, J1.S2, J2.A1, J2.A12, J2.B1, J2.B12, J2.SH, J3.2, J4.4, J5.4, J6.4, J7.1, J8.6, J8.11, R3.2, R6.2, R8.2, R9.2, R15.2, R17.2, R19.2, R20.2, R21.2, R22.2, R23.2, R28.2, R29.2, R30.2, S4.3, S5.1, TP32.1, TP33.1, TP34.1, U1.2, U1.25, U2.2, U3.1, U4.8, U4.17, U4#2.8, U4#2.17, U5.8, U5.37, U5.49, U6.5, U6.10, U6.12
unnamed: C12.1, U5.10
unnamed: C18.1, D10.1, D11.2
unnamed: C18.2, D12.2, L1.2, Q5.3
unnamed: C20.1, C23.1, U5.9
unnamed: D4.2, R5.1
unnamed: D5.2, R7.1
unnamed: D6.1, R10.2
unnamed: D7.2, R11.2
unnamed: D9.1, R18.2
unnamed: D13.2, D14.4
unnamed: D14.2, D15.4
unnamed: D15.2, D16.4
unnamed: D16.2, D17.4
unnamed: Q1.1, R13.1
unnamed: Q2.1, R14.1
unnamed: Q3.2, Q4.2
unnamed: R1.2, R2.1, U1.8
unnamed: R2.2, R3.1
unnamed: R4.2, U1.9
unnamed: R8.1, U2.5
unnamed: R10.1, R11.1, U2.1
unnamed: R26.2, R27.1
unnamed: S6.SH1, S6.SH2
unnamed: U4.1, U4#2.1
unnamed: U4.6, U4#2.6
unnamed: U4.7, U4#2.7
VBUS: C3.1, D3.1, D7.1, D8.2, J2.A4, J2.A9, J2.B4, J2.B9, Q3.1, R1.1, R17.1, U2.4
